tuyen123-1/CLKK/Code/image/bat_25.png

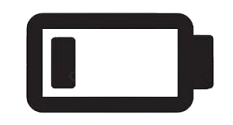
Code/image/bat_25.png
