tuyen123-1/CLKK/Code/image/bat_75.png

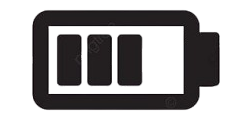
Code/image/bat_75.png
