tuyen123-1/CLKK/PCB_Project/PCB_Project.pdf

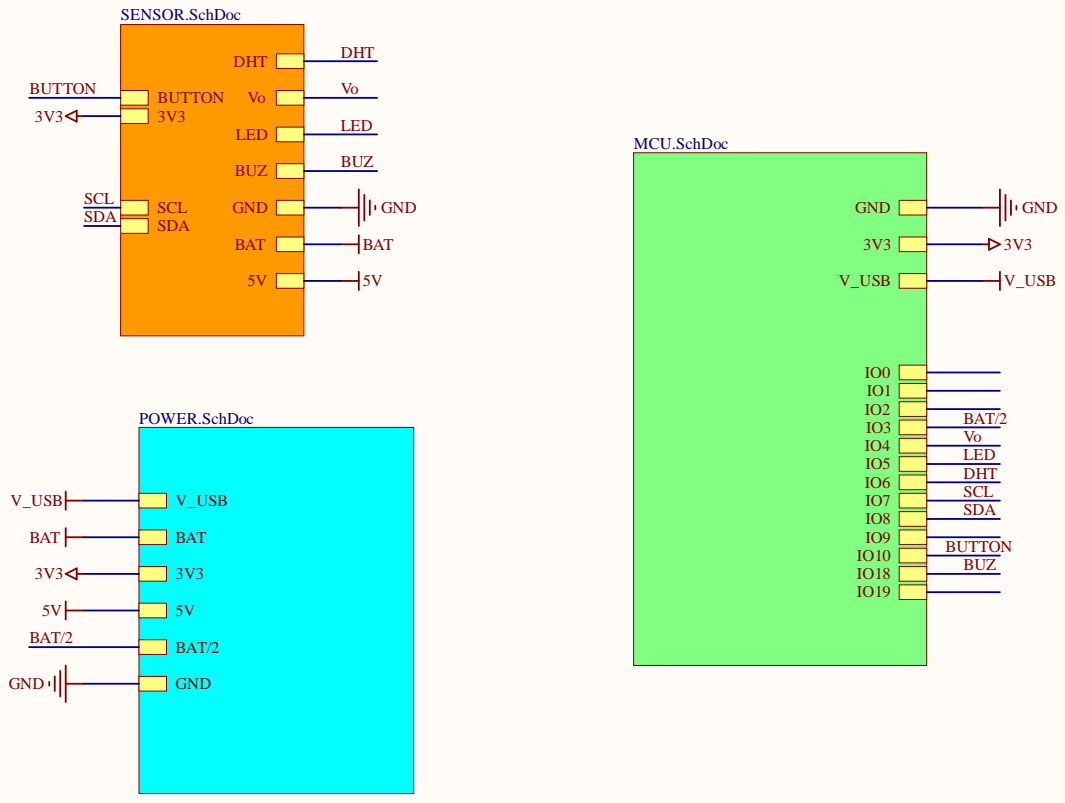
[picture p3: page 1]

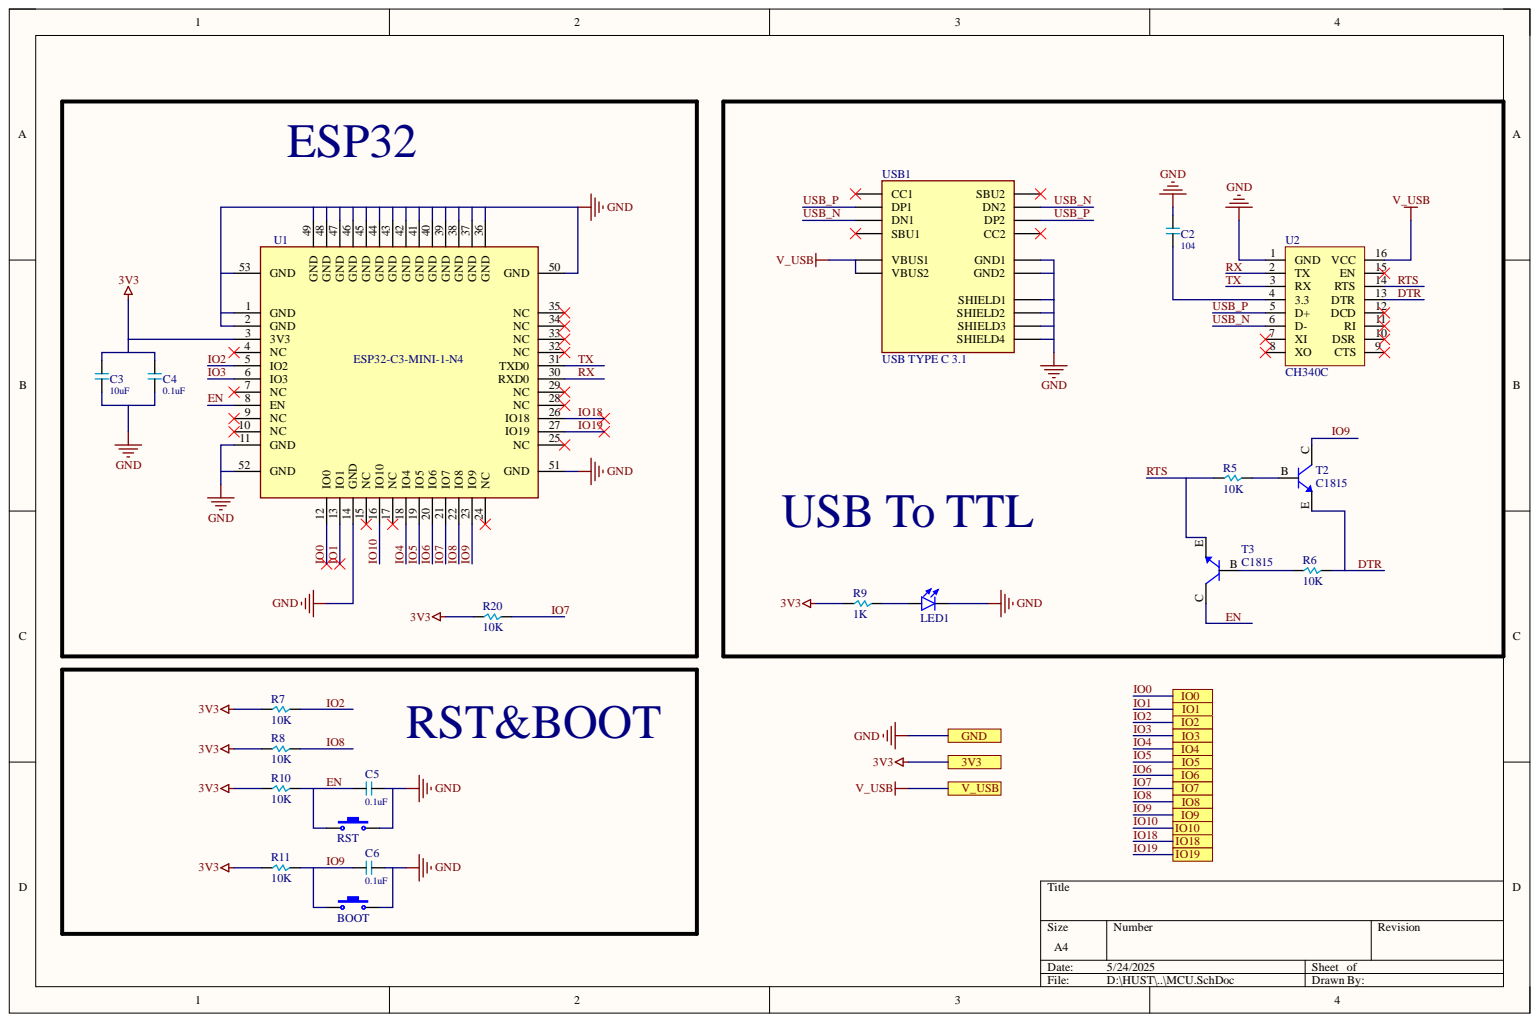
[picture p4: page 2]

GND 36 GND 37 GND 38 GND 39 GND 40 GND 41 GND 42 GND 43 GND 44 GND 45 GND 46 GND 47 GND 48 GND 49

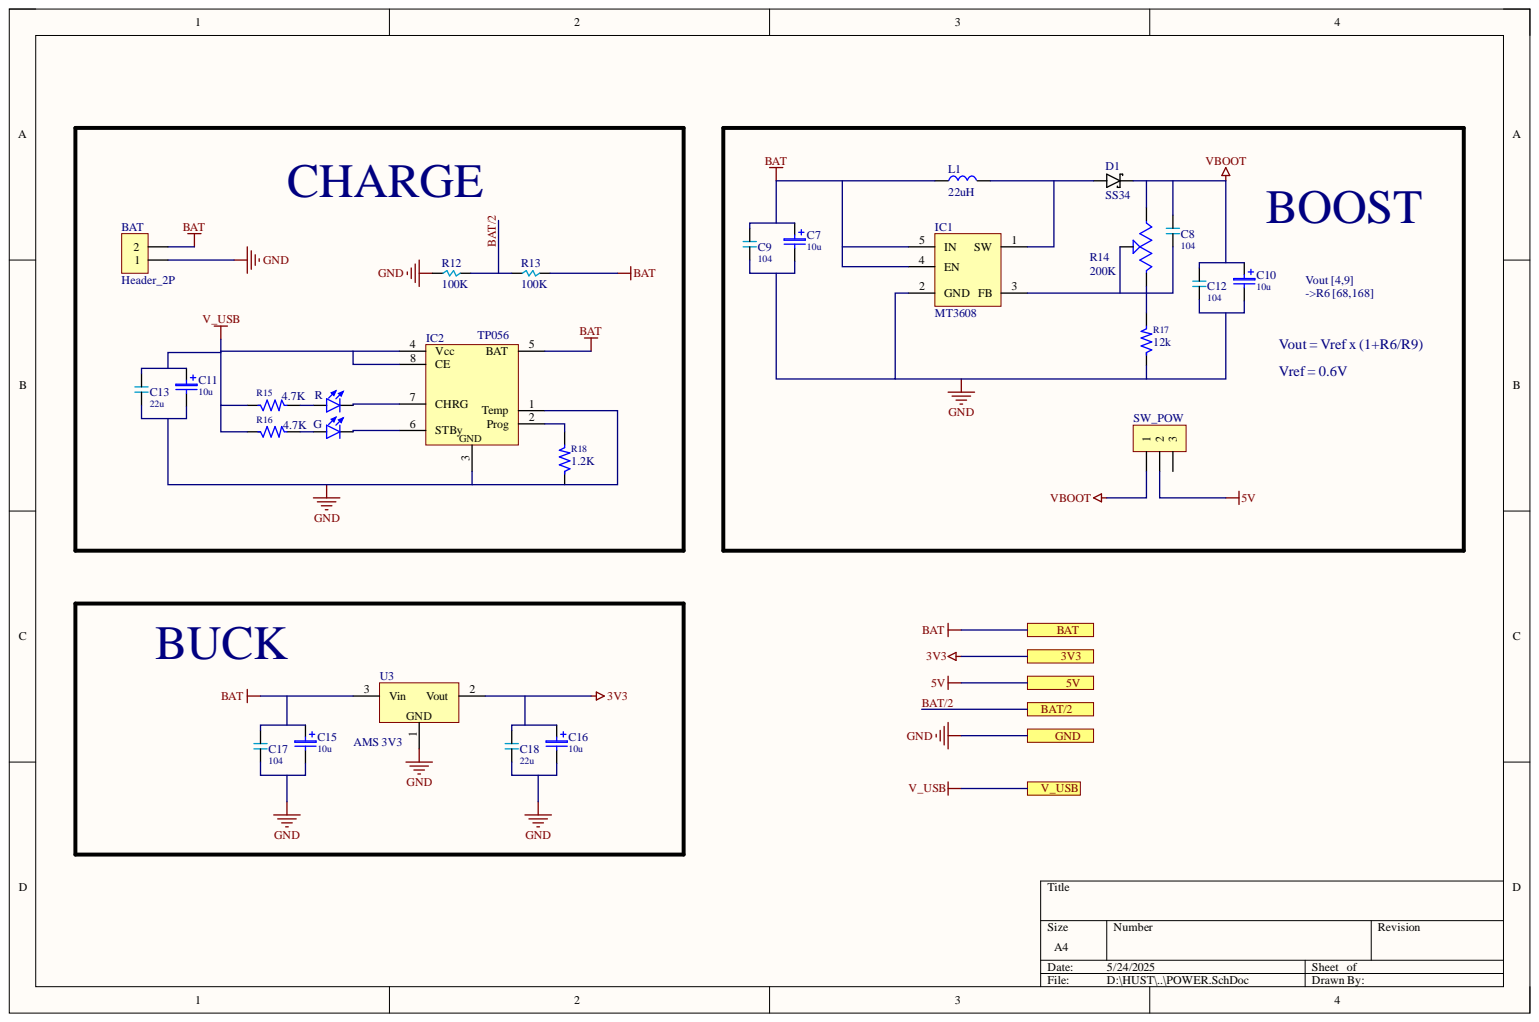
[picture p5: page 3]

Prog | 2 R18 1.2K

G | STBy 6

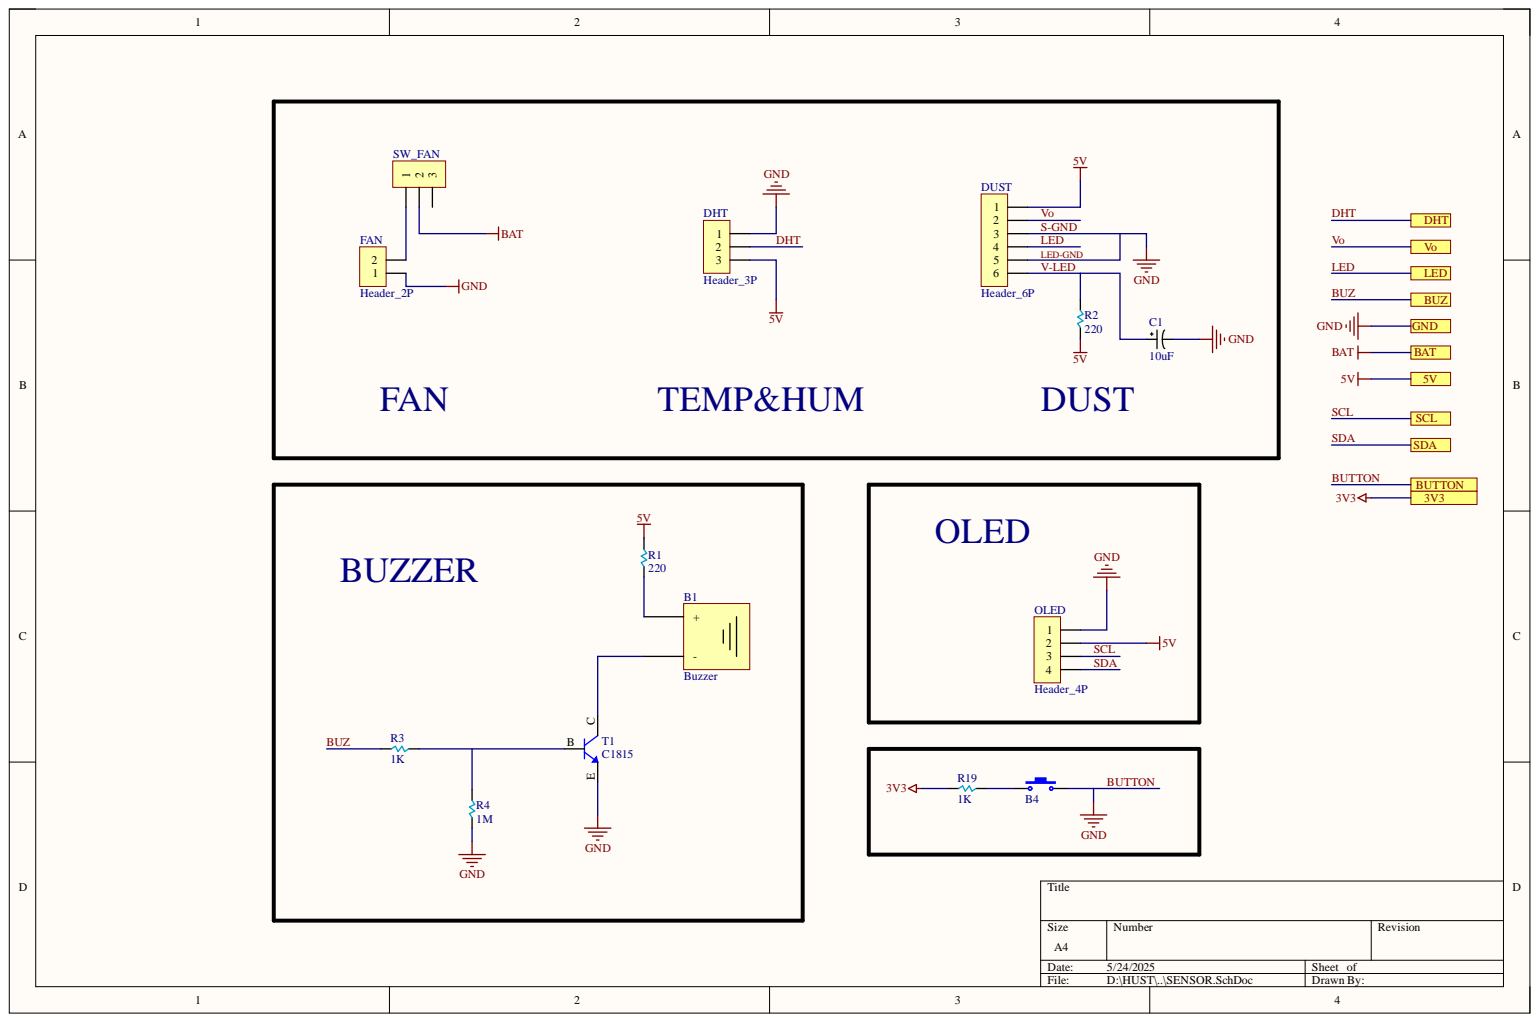
[picture p6: page 4]

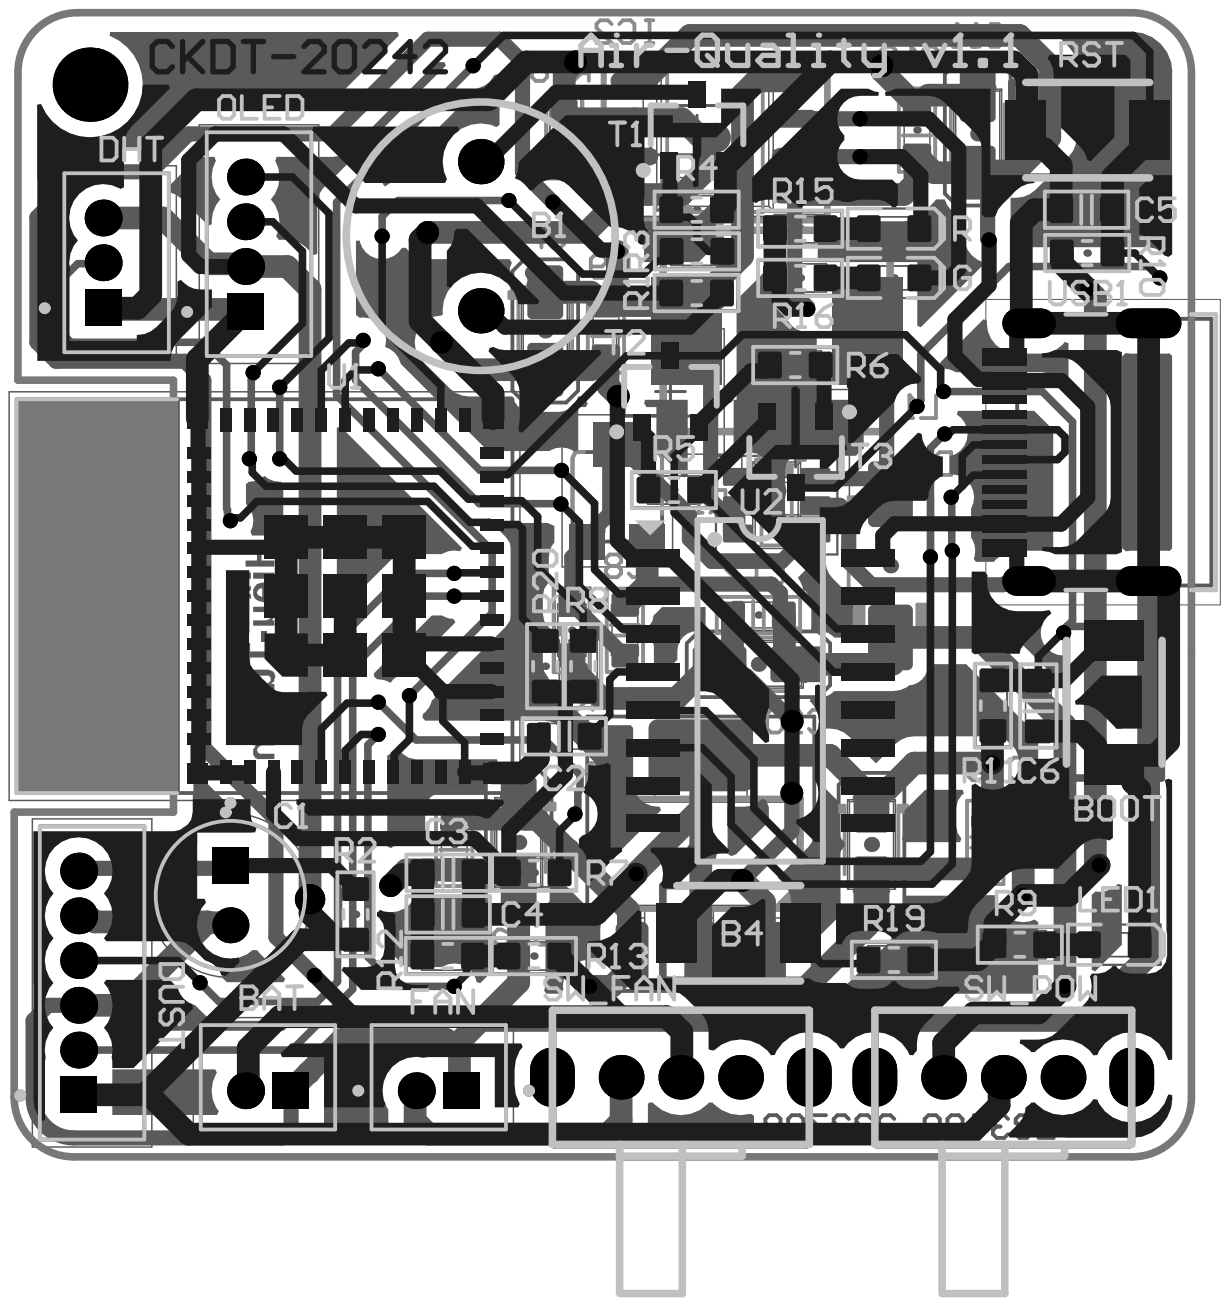
[picture p7: page 5]

Comment | Description | Designator | Footprint | LibRef | Quantity
Buzzer | | B1 | Buzzer | Buzzer | 1
BUTTON | | B4, BOOT, RST | BUTTON3x4x2 | BUTTON | 3
Header_2P | | BAT, FAN | 2P_1.5_V | Header_2P | 2
10uF | | C1 | CAP5x11 | Cap_P | 1
104 | | C2, C8, C9, C12, C17 | CAP0603 | CAP | 5
10uF | | C3 | CAP0603 | CAP | 1
0.1uF | | C4, C5, C6 | CAP0603 | CAP | 3
10u | | C7, C10, C11, C15, C16 | CAP_T3216(1208) | CAP_T | 5
22u | | C13, C18 | CAP0603 | CAP | 2
SS34 | | D1 | DO214AC-SMA | DIODES | 1
Header_3P | | DHT | 3P_1.5_V | Header_3P | 1
Header_6P | | DUST | 6P_1.5_V | Header_6P | 1
Green | | G, LED1, R | LED0603 | LEDSM | 3
MT3608 | | IC1 | SOT23-6 | MT3608 | 1
TP056 | | IC2 | SOIC8 | TP4056 | 1
22uH | | L1 | INDUCTOR0630 | IDT | 1
Header_4P | | OLED | 4P_1.5_V | Header_4P | 1
220 | | R1, R2 | RES0603 | RES | 2
1K | | R3, R9, R19 | RES0603 | RES | 3
1M | | R4 | RES0603 | RES | 1
10K | | R5, R6, R7, R8, R10, R11, R20 | RES0603 | RES | 7
100K | | R12, R13 | RES0603 | RES | 2
200K | SMD | R14 | RESVARIABLE | Res_variable | 1
4.7K | Res0805 | R15, R16 | RES0603 | ResSMD | 2
12k | Res0805 | R17 | RES0603 | ResSMD | 1
1.2K | Res0805 | R18 | RES0603 | ResSMD | 1
SWITCH | | SW_FAN, SW_POW | SwitchSK12D07 | SWITCH | 2
C1815 | | T1, T2, T3 | C1815 | C1815 | 3
ESP32-C3-MINI-1-N4 | | U1 | ESP32-C3-MINI-1-N4 | ESP32-C3-MINI-1-N4 | 1
CH340C | | U2 | SOP16 | CH340G | 1
AMS3V3 | | U3 | SOT223 | AMS1117 | 1
USBTYPEC3.1 | 16P | USB1 | USBTYPEC3.1 | USBTYPEC3.1 | 1
