tuyen123-1/CLKK/(list of files, drawings)

Other design files:
PCB_Project/AIR_QUALITY.PcbDoc
PCB_Project/AIR_QUALITY.SchDoc
PCB_Project/MCU.SchDoc
PCB_Project/PCB_Project.PrjPcb
PCB_Project/POWER.SchDoc
PCB_Project/SENSOR.SchDoc
