tuyen123-1/CLKK/(commit log)

2025-05-15 update all file
    [AIR_QUALITY.SchDoc, MCU.SchDoc, PCB_Project.PrjPcb, POWER.SchDoc, SENSOR.SchDoc]
2025-05-16 update header
    [AIR_QUALITY.SchDoc, MCU.SchDoc, PCB_Project.PrjPcb, POWER.SchDoc, SENSOR.SchDoc]
2025-05-24 update final
    [AIR_QUALITY.PcbDoc, AIR_QUALITY.SchDoc, MCU.SchDoc, PCB1.PcbDoc, PCB_Project.PrjPcb, POWER.SchDoc, SENSOR.SchDoc]
2025-06-08 update code + pcb 3D
    [PCB_Project.PrjPcb, POWER.SchDoc, SENSOR.SchDoc]
